souhailghafoud/Domination-PUA/(list of files, cad)

Other CAD files:
Hardware/Enclosure/UpperArm_Enclosure.f3z
