souhailghafoud/Domination-PUA/Hardware/PCB/XstractiK_Domination_Player_UpperArm_V1.brd

## EAGLE design Hardware/PCB/XstractiK_Domination_Player_UpperArm_V1.brd (2022-05-24)

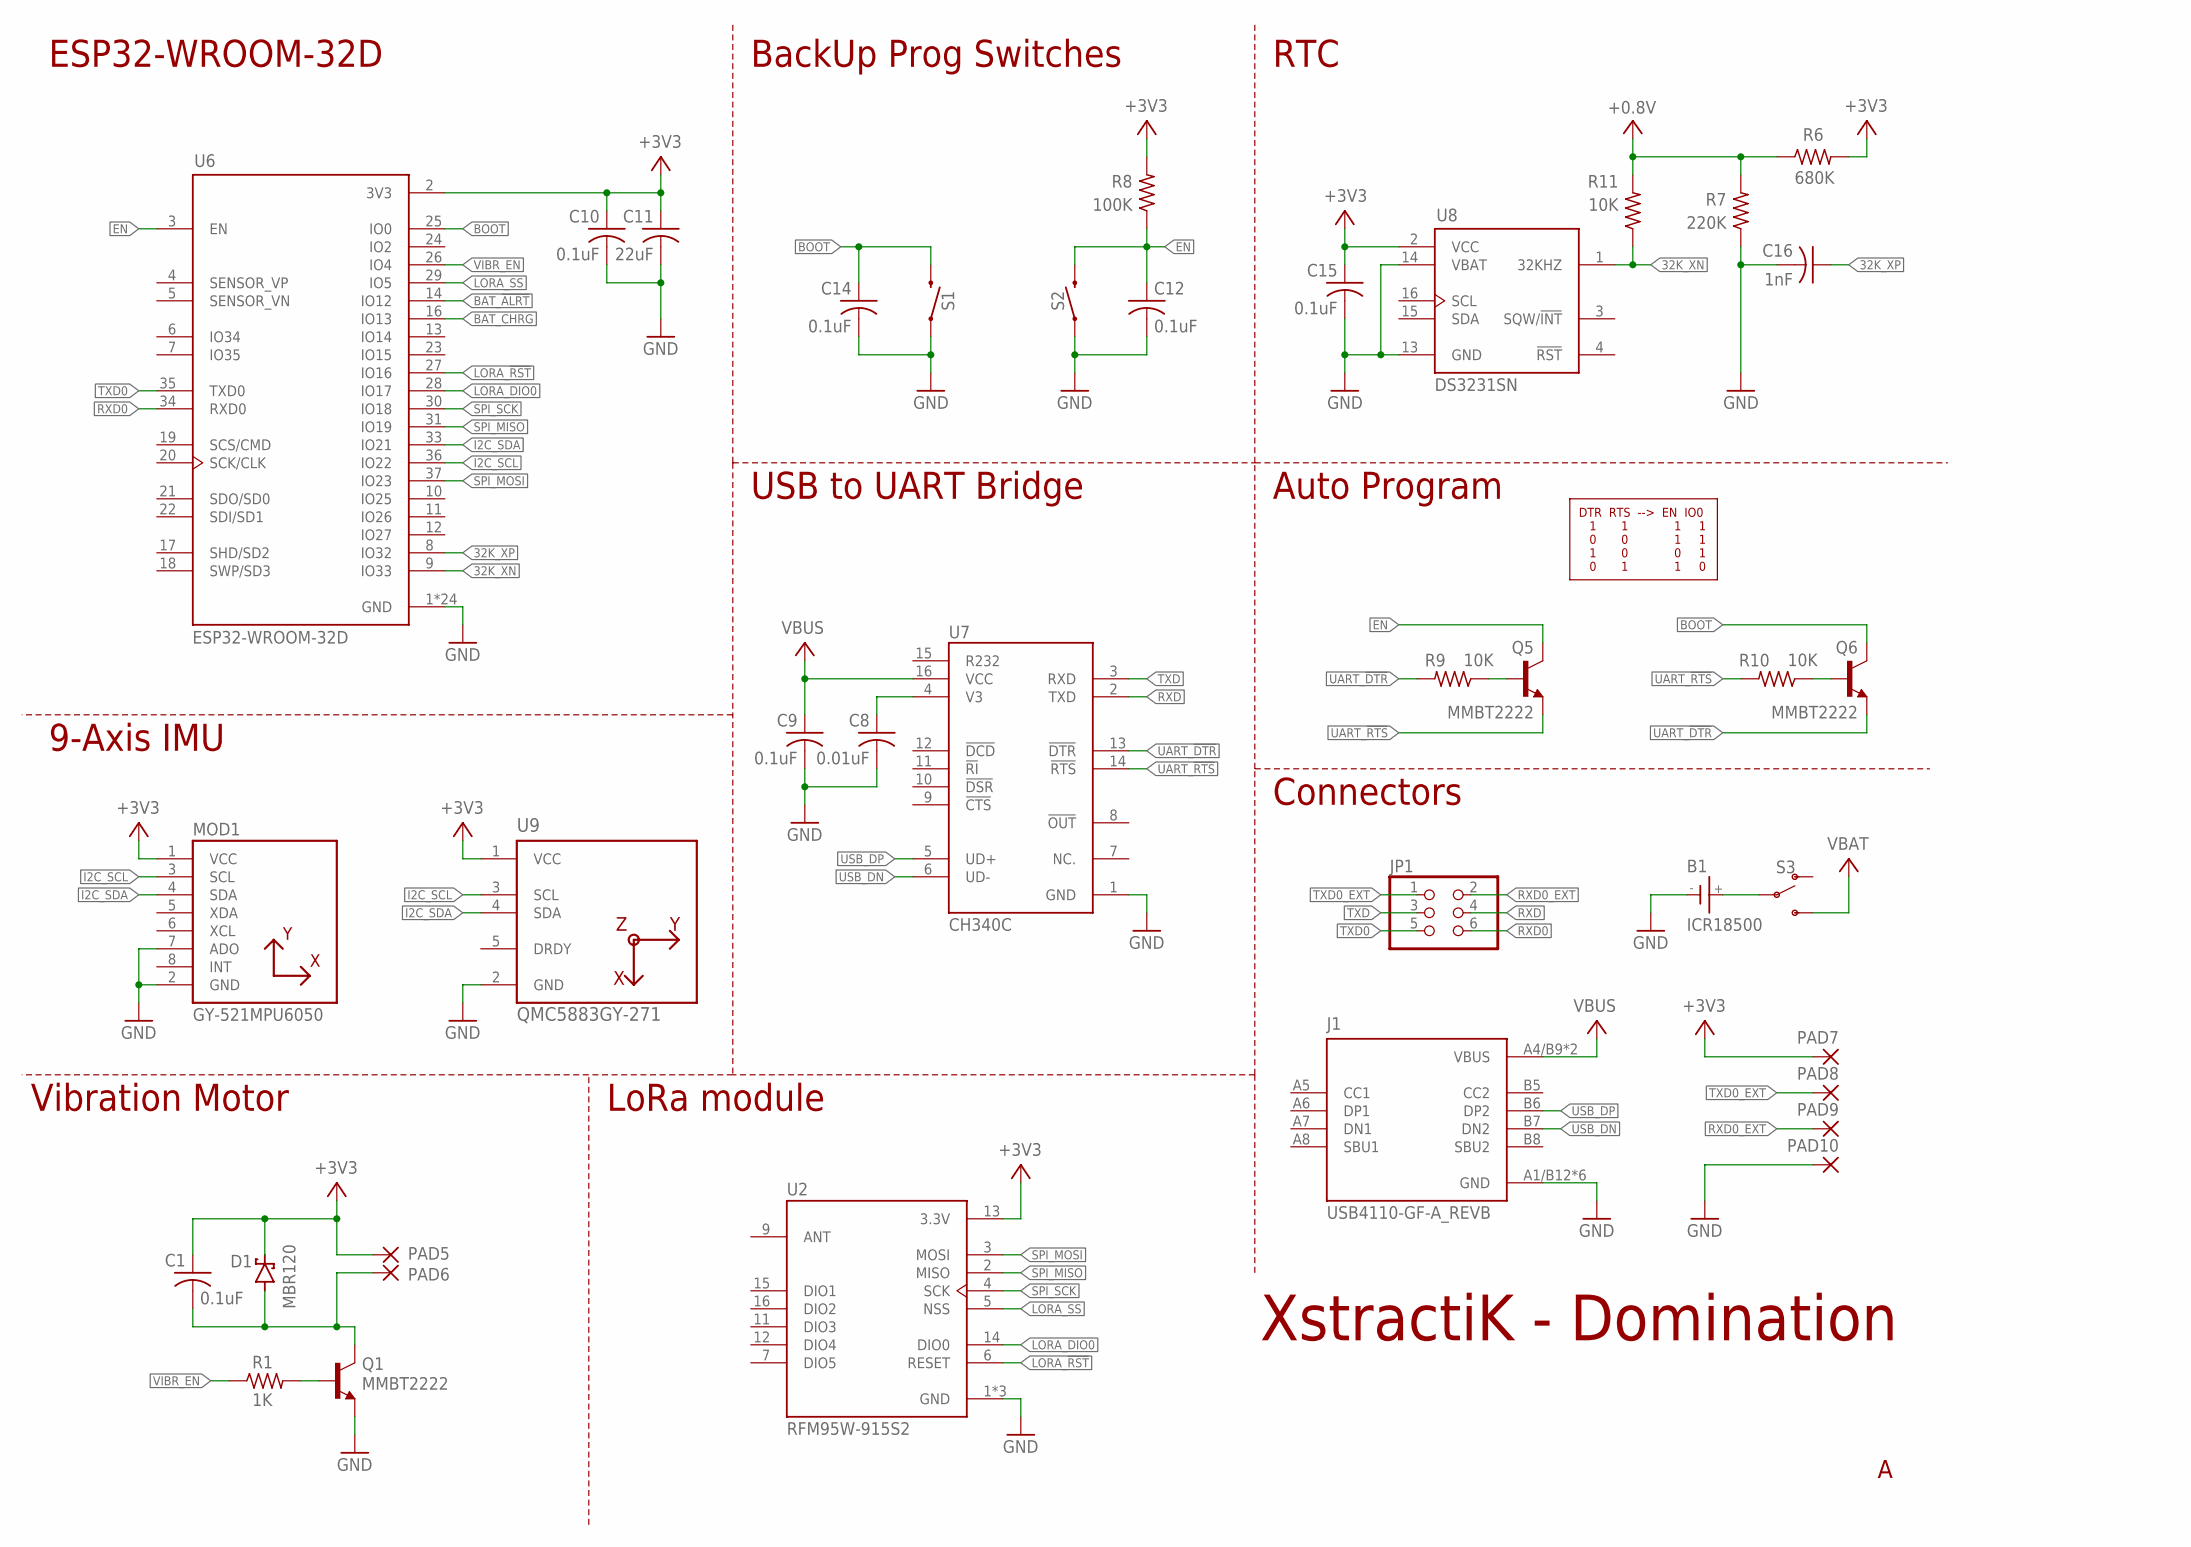
[picture p1: schematic XstractiK_Domination_Player_UpperArm_V1.sch, sheet 1]

Parts:
B1: ICR18500
C1, C9, C10, C12, C14, C15: 0.1uF; C0805
C8: 0.01uF; C0805
C11: 22uF; C0805
C16: 1nF; C0805
D1: ON_SEMICONDUCTOR_MBR120VLSFT1GON_SEMICONDUCTOR_MB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; ON_SEMICONDUCTOR_MBR120VLSFT1G_0
J1: USB4110-GF-A_REVB; GCT_USB4110-GF-A_REVB
JP1: PINHD-2X3; 2X03
MOD1: GY-521MPU6050; GY-521
PAD5, PAD6: WIREPAD1,6/0,8; 1,6/0,8
PAD7, PAD8, PAD9, PAD10: WIREPADSMD1,27-254; SMD1,27-2,54
Q1, Q5, Q6: MMBT2222; SOT23-BEC
R1: 1K; R0805
R6: 680K; R0805
R7: 220K; R0805
R8: 100K; R0805
R9, R10, R11: 10K; R0805
S1, S2: MOMENTARY-SWITCH-SPST-SMD-5.2MM-TALL; TACTILE_SWITCH_SMD_5.2MM
S3: SWITCH-SPDT-SMD-RIGHT-ANGLE; SWITCH_SPST_SMD_A
U2: RFM95W-915S2; XCVR_RFM95W-915S2
U6: ESP32-WROOM-32D; MODULE_ESP32-WROOM-32D
U7: CH340C; SOIC127P600X180-16N
U8: DS3231SN; SOIC127P1032X265-16N
U9: QMC5883GY-271; GY-271

Connections:
32K_XN: R11.1, U6.9 (IO33), U8.1 (32KHZ)
32K_XP: C16.1, U6.8 (IO32)
+: B1.+, S3.2
+0.8V: R6.1, R7.2, R11.2
+3V3: C1.1, C10.1, C11.1, C15.1, D1.1 (K), MOD1.1 (VCC), PAD5.1, PAD7.1, R6.2, R8.2, U2.13 (3.3V), U6.2 (3V3), U8.2 (VCC), U9.1 (VCC); also elsewhere on the board
-: B1.-
BAT_!ALRT: U6.14 (IO12); also elsewhere on the board
BAT_CHRG: U6.16 (IO13); also elsewhere on the board
BOOT: C14.1, Q6.C, S1.3 (2), U6.25 (IO0)
EN: C12.1, Q5.C, R8.1, S2.3 (2), U6.3 (EN)
GND: C8.2, C9.2, C10.2, C11.2, C12.2, C14.2, C15.2, C16.2, J1.A1/B12 (GND), J1.B1/A12 (GND), J1.S1 (GND), J1.S2 (GND), J1.S3 (GND), J1.S4 (GND), MOD1.2 (GND), MOD1.7 (ADO), PAD10.1, Q1.E, R7.1, S1.1, S2.1, U2.1 (GND), U2.8 (GND), U2.10 (GND), U6.1 (GND), U6.15 (GND), U6.38 (GND), U6.39_1 (GND), U6.39_2 (GND), U6.39_3 (GND), U6.39_4 (GND), U6.39_5 (GND), U6.39_6 (GND), U6.39_7 (GND), U6.39_8 (GND), U6.39_9 (GND), U6.39_10 (GND), U6.39_11 (GND), U6.39_12 (GND), U6.39_13 (GND), U6.39_14 (GND), U6.39_15 (GND), U6.39_16 (GND), U6.39_17 (GND), U6.39_18 (GND), U6.39_19 (GND), U6.39_20 (GND), U6.39_21 (GND), U7.1 (GND), U8.13 (GND), U8.14 (VBAT), U9.2 (GND); also elsewhere on the board
I2C_SCL: MOD1.3 (SCL), U6.36 (IO22), U9.3 (SCL); also elsewhere on the board
I2C_SDA: MOD1.4 (SDA), U6.33 (IO21), U9.4 (SDA); also elsewhere on the board
LORA_!RST: U2.6 (RESET), U6.27 (IO16)
LORA_DIO0: U2.14 (DIO0), U6.28 (IO17)
LORA_SS: U2.5 (NSS), U6.29 (IO5)
M-: C1.2, D1.2 (A), PAD6.1, Q1.C
unnamed: Q1.B, R1.2
unnamed: Q6.B, R10.1
unnamed: Q5.B, R9.1
RXD: JP1.4, U7.2 (TXD)
RXD0: JP1.6, U6.34 (RXD0)
RXD0_EXT: JP1.2, PAD9.1
SPI_MISO: U2.2 (MISO), U6.31 (IO19)
SPI_MOSI: U2.3 (MOSI), U6.37 (IO23)
SPI_SCK: U2.4 (SCK), U6.30 (IO18)
TXD: JP1.3, U7.3 (RXD)
TXD0: JP1.5, U6.35 (TXD0)
TXD0_EXT: JP1.1, PAD8.1
UART_!DTR: Q6.E, R9.2, U7.13 (!DTR)
UART_!RTS: Q5.E, R10.2, U7.14 (!RTS)
USB_DN: J1.B7 (DN2), U7.6 (UD-)
USB_DP: J1.B6 (DP2), U7.5 (UD+)
V3: C8.1, U7.4 (V3)
VBAT: S3.3 (S); also elsewhere on the board
VBUS: C9.1, J1.A4/B9 (VBUS), J1.B4/A9 (VBUS), U7.16 (VCC); also elsewhere on the board
VIBR_EN: R1.1, U6.26 (IO4)

Notes on the sheet:
XstractiK - Domination
Connectors
ESP32-WROOM-32D
Vibration Motor
LoRa module
USB to UART Bridge
Auto Program
RTC
BackUp Prog Switches
DTR RTS --> EN IO0 1 1 1 1 0 0 1 1 1 0 0 1 0 1 1 0
9-Axis IMU

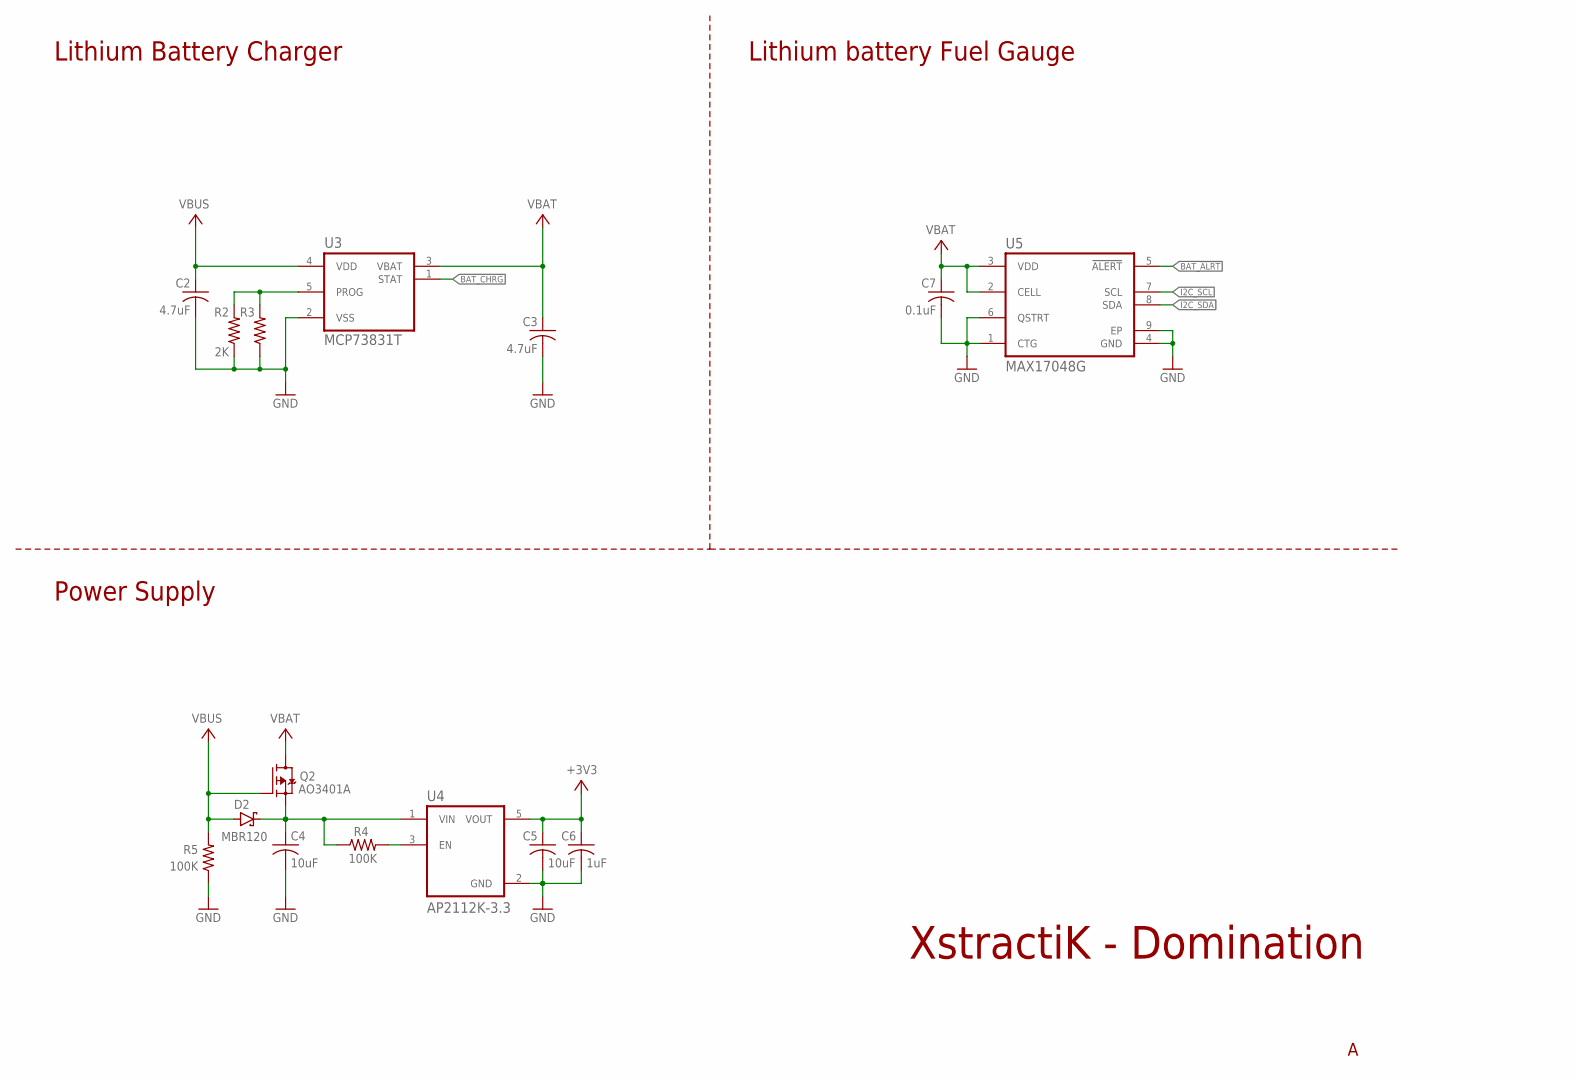
[picture p2: schematic XstractiK_Domination_Player_UpperArm_V1.sch, sheet 2]

Parts:
C2, C3: 4.7uF; C0805
C4, C5: 10uF; C0805
C6: 1uF; C0805
C7: 0.1uF; C0805
D2: ON_SEMICONDUCTOR_MBR120VLSFT1GON_SEMICONDUCTOR_MB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; ON_SEMICONDUCTOR_MBR120VLSFT1G_0
Q2: AO3401A; SOT23-3
R2: 2K; R0805
R3: R-US_R0805; R0805
R4, R5: 100K; R0805
U3: MCP73831T; SOT95P270X145-5N
U4: AP2112K-3.3; SOT95P285X140-5N
U5: MAX17048G; SON50P200X200X80-9N

Connections:
+3V3: C5.1, C6.1, U4.5 (VOUT); also elsewhere on the board
BAT_!ALRT: U5.5 (!ALERT); also elsewhere on the board
BAT_CHRG: U3.1 (STAT); also elsewhere on the board
CHRG_PROG: R2.2, R3.2, U3.5 (PROG)
GND: C2.2, C3.2, C4.2, C5.2, C6.2, C7.2, R2.1, R3.1, R5.1, U3.2 (VSS), U4.2 (GND), U5.1 (CTG), U5.4 (GND), U5.6 (QSTRT), U5.9 (EP); also elsewhere on the board
I2C_SCL: U5.7 (SCL); also elsewhere on the board
I2C_SDA: U5.8 (SDA); also elsewhere on the board
REG_EN: R4.2, U4.3 (EN)
REG_VIN: C4.1, D2.1 (K), Q2.2 (S), R4.1, U4.1 (VIN)
VBAT: C3.1, C7.1, Q2.3 (D), U3.3 (VBAT), U5.2 (CELL), U5.3 (VDD); also elsewhere on the board
VBUS: C2.1, D2.2 (A), Q2.1 (G), R5.2, U3.4 (VDD); also elsewhere on the board

Notes on the sheet:
Lithium Battery Charger
Power Supply
Lithium battery Fuel Gauge
XstractiK - Domination

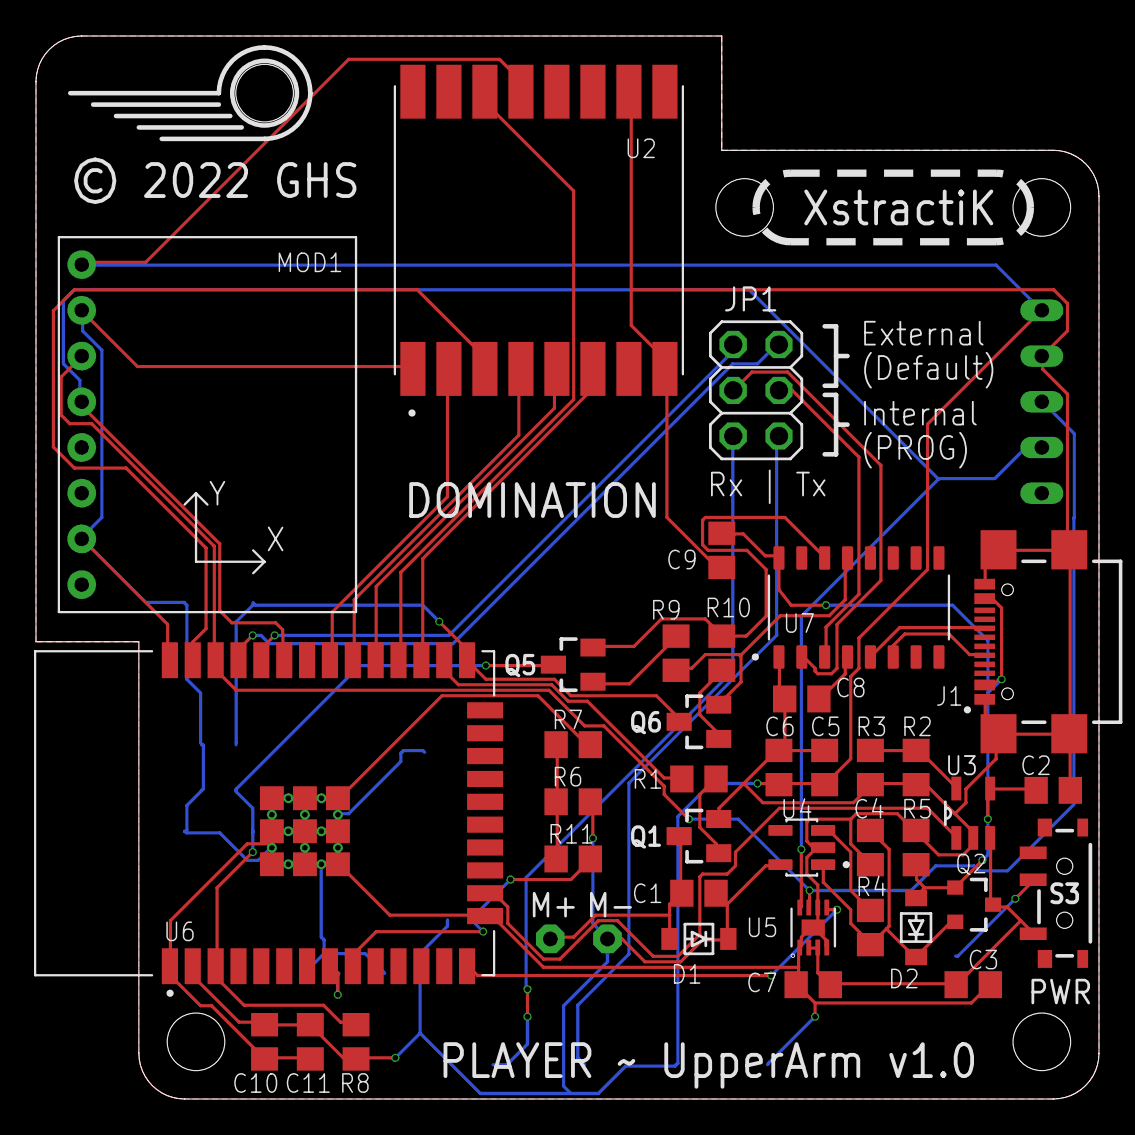
[picture p3: board XstractiK_Domination_Player_UpperArm_V1.brd from above]

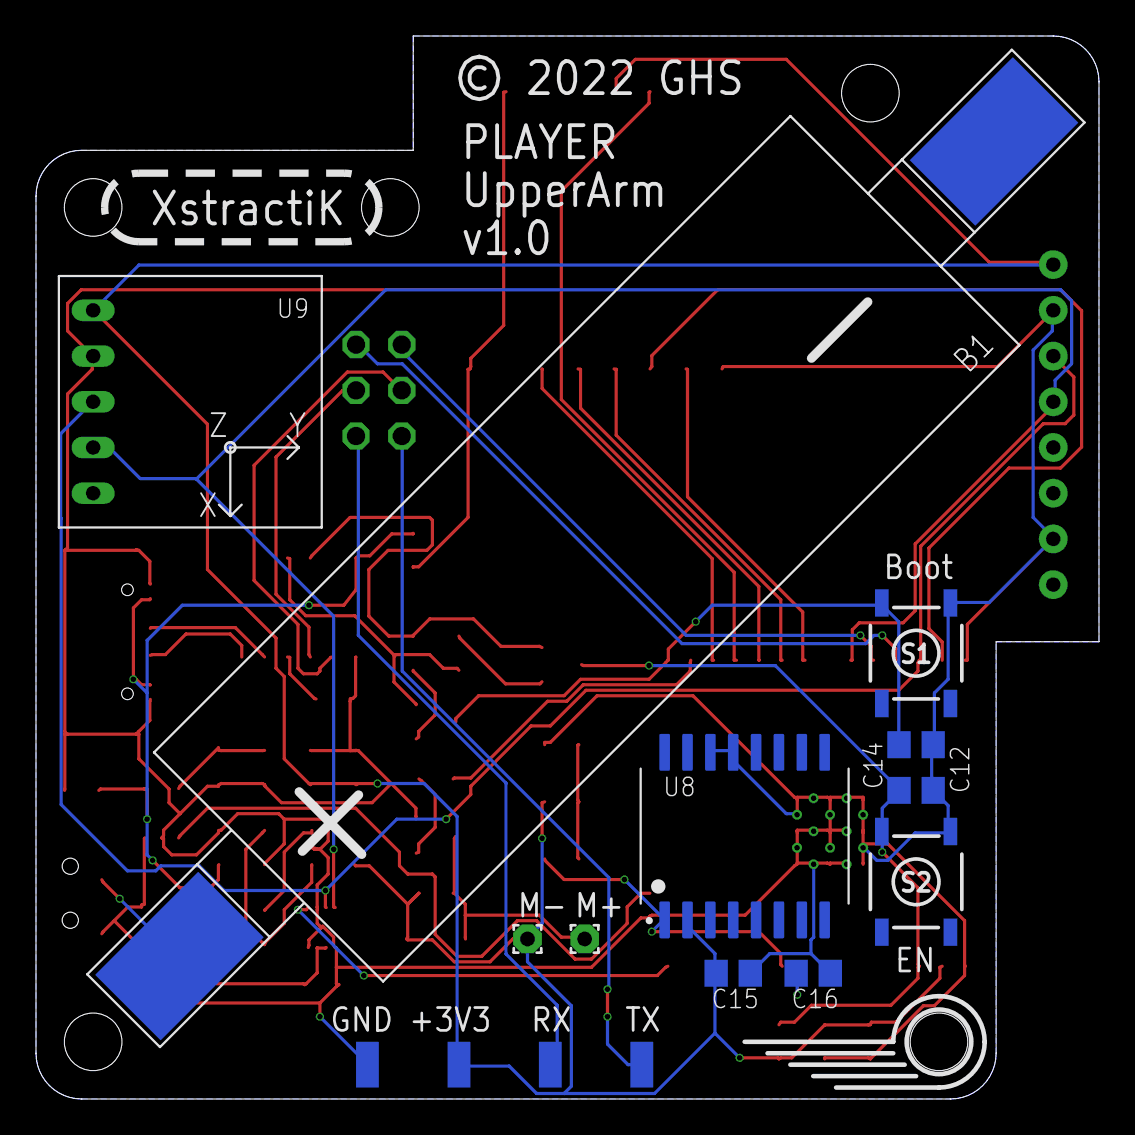
[picture p4: board XstractiK_Domination_Player_UpperArm_V1.brd from below]

Board: 2 copper layers, 59.1 x 59.1 mm, 53 parts (15 on the bottom side), 39 nets.
