souhailghafoud/Domination-PUA/(commit log)

2022-04-06 LoRa driver
    Send & receive packets fully operational (Tested)
2022-04-06 Receive CP status changes over LoRa
    Receive CP status changes from CP :
    - When CP was captured
    - When CP capture is in progress
    LoRa packet frame :
    - cp_id:%d, cp_status:%d, dominant_team:%d
    LoRa packet frame content :
    - cp_id : CP identification (0 or 1 or 2)
    - cp_status : CP status (0 or 1)
    - dominant_team : Team affecting status change (0 or 1)
2022-04-24 Add datasheets
    - Coin flat vibration motor
    - ESP32 DevKitC V4
    - ESP32-WROOM-32D/U
    - RFM95W
    - MPU6050
2022-04-24 Add Eagle libraries
    - ESP32-DEVKITC-32U/D
    - ESP32-WROOM-32D
    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
2022-04-24 Add schematic + Eagle libraries + datasheets
    Schematic :
    - ESP32 (DevKitC-32D)
    - IMU (MPU6050)
    - LoRa module (RFM95W)
    - Vibration motor
    - LiPo battery charger (MCP73831T)
    - LDO regulator (AP2112-3.3)
    Eagle libraries + Datasheets :
    - Rectifier diode (1N4001)
    - P-Channel MOSFET (A03401A)
    - LDO regulator (AP2112-3.3)
    - Amplifier transistor (MMBT2222)
    - Schottky diode (MBR120VLSFT1G)
    - LiPo battery charger (MCP73831T-3)
    [XstractiK_Domination_Player_UpperArm.sch]
2022-04-26 Schematic + Libraries + Datasheets
    - Li-Ion battery fuel gauge (MAX17048G)
    - USB to UART bridge (CH340C)
    - Connectors for USB-C, Breakout pins, Li-Ion battery
    - Mount holes
    Libraries :
    - Supply
    - Switches
    - Fuel gauge
    - Li-Ion battery
    Datasheets :
    - Li-Ion battery fuel gauge (MAX17048G)
    - USB to UART bridge (CH340C)
    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
    [XstractiK_Domination_Player_UpperArm_V1.sch]
2022-04-26 Reallocate pins + Add vibration motor
    Reallocate pins :
    - I2C
    - LoRa
    Vibration motor :
    - Vibrate when
    - the player's device is initialized (2x for 0.5sec)
    - a CP status changes (2x for 1sec)
    - the player is eliminated (1x for 1sec)
    - the player revives (2x for 1sec)
    [MPU6050.c, MPU6050.h, lora.c, main.c, vibration.c, vibration.h]
2022-04-29 Add RTC Clock 32.768 kHz
    DS3231 used as external RTC clock for ESP32
    [XstractiK_Domination_Player_UpperArm_V1.sch]
2022-05-01 Vibration + BLE + Code Refactor
    Vibration :
    - Create task in init function
    - Add queue for vibration enable requests
    BLE :
    - Add BLE files into Comms component (ble.c ble.h)
    - Add EventGroup for callbacks
    - Add queue for scan results
    [MPU6050.c, MPU6050.h, ble.c, ble.h, i2c.c, i2c.h, lora.c, lora.h]
2022-05-02 Player Status + Crash Fix + Code Refactor
    Player Status :
    - CP scan removed
    Crash Fix :
    - Missing semi-colon in I2C header file
    [i2c.c, i2c.h, main.c, vibration.c]
2022-05-02 Schematic + Library + Datasheet
    Add 3-axis Magnetic sensor module (HMC5883)
    [XstractiK_Domination_Player_UpperArm_V1.sch]
2022-05-24 Schematic and PCB
    UpperArm and Forearm designs
    [XstractiK_Domination_Player_Connector_V1.brd, XstractiK_Domination_Player_Connector_V1.sch, XstractiK_Domination_Player_Forearm_V1.brd, XstractiK_Domination_Player_Forearm_V1.sch, XstractiK_Domination_Player_UpperArm_V1.brd, XstractiK_Domination_Player_UpperArm_V1.sch]
2022-05-24 Enclosure 3D design
    UpperArm and Forearm
    [Forearm_Connector.f3z, Forearm_Enclosure.f3z, UpperArm_Enclosure.f3z]
2022-05-25 Add IMU filtering algorithm + Code refactor
    Filter MPU6050 accelerometer and gyroscope data with Madgwick algorithm to generate quaternions and Euler angles
2022-05-30 Remove Forearm hardware files from repo
    [Forearm_Connector.f3z, Forearm_Enclosure.f3z, UpperArm_Enclosure.f3z, XstractiK_Domination_Player_Connector_V1.brd, XstractiK_Domination_Player_Connector_V1.sch, XstractiK_Domination_Player_Forearm_V1.brd, XstractiK_Domination_Player_Forearm_V1.sch, XstractiK_Domination_Player_UpperArm_V1.brd]
