souhailghafoud/Domination-PUA/(notices)

Notices in the files:
Hardware/PCB/XstractiK_Domination_Player_UpperArm_V1.brd:
© 2022 GHS
parts and their libraries:
Switches: Licensing: Creative Commons ShareAlike 4.0 International - https://creativecommons.org/licenses/by-sa/4.0
